veddd01/industrial-safety-rover/hardware/README.md

# Hardware documents

`bom.csv` records the supplied proposal bill of materials and status notes.

Export the approved EasyEDA source and PDF/PNG schematics into `schematics/` when available. The current update source set did not include the `.epro` project or the three referenced schematic exports, so no substitute wiring drawings have been fabricated.

## Procurement note requiring verification

The supplied proposal lists one Ra-02 module at ₹530, while the current BOM records two modules in use at the same line-item cost. Verify the actual quantity and purchase cost against receipts before revising the BOM total. The proposal PDF is a historical cost-analysis document and should remain unchanged; any correction belongs in a separately dated actual-procurement record.
