veddd01/industrial-safety-rover/docs/README.md

# Project documentation

- `images/` contains the supplied rover and hardware photographs used by the README.
- `test_plan.md` contains the hardware, communication, and dashboard verification checklist.

The final capstone report PDF, raw 3 November 2026 bench CSV, and schematic exports were not included in the source files available for this update. The cost-analysis PDF and presentation deck were reviewed but are not copied into the public source tree because the supplied copies contain personal information.
