veddd01/industrial-safety-rover/firmware/base_station/secrets.example.h

// Copy to secrets.h and replace every placeholder locally. Never commit secrets.h.
#pragma once

#define UPLINK_SSID       "YOUR_PHONE_HOTSPOT_SSID"
#define UPLINK_PASSWORD   "REPLACE_WITH_NEW_HOTSPOT_PASSWORD"
#define APPS_SCRIPT_URL   "https://script.google.com/macros/s/REPLACE_WITH_NEW_DEPLOYMENT_ID/exec"
