veddd01/industrial-safety-rover/firmware/drive_node/secrets.example.h

// Copy to secrets.h and use a new, strong rover AP password. Never commit secrets.h.
#pragma once

#define ROVER_AP_SSID     "ESP32_CAR"
#define ROVER_AP_PASSWORD "REPLACE_WITH_NEW_ROVER_AP_PASSWORD"
