veddd01/industrial-safety-rover/(commit log)

2026-03-26 Make panels into buttons
2026-11-04 feat: add AAHARR firmware templates, Apps Script, BOM and test plan
    [bom.csv]
2026-11-04 feat(firmware): add sensing, drive and ESP32-CAM nodes
2026-11-04 docs: add rover prototype hero photograph
2026-11-05 fix(firmware): restrict drive CORS to local operator console
    [drive_node.ino]
2026-11-05 docs: flag Ra-02 BOM cost discrepancy for verification
